zzvladyzz/Karane_Micromouse/IndaV1_Kicad/IndaV1_Kicad.kicad_pcb

## KiCad design IndaV1_Kicad/IndaV1_Kicad.kicad_pcb (2026-05-10)

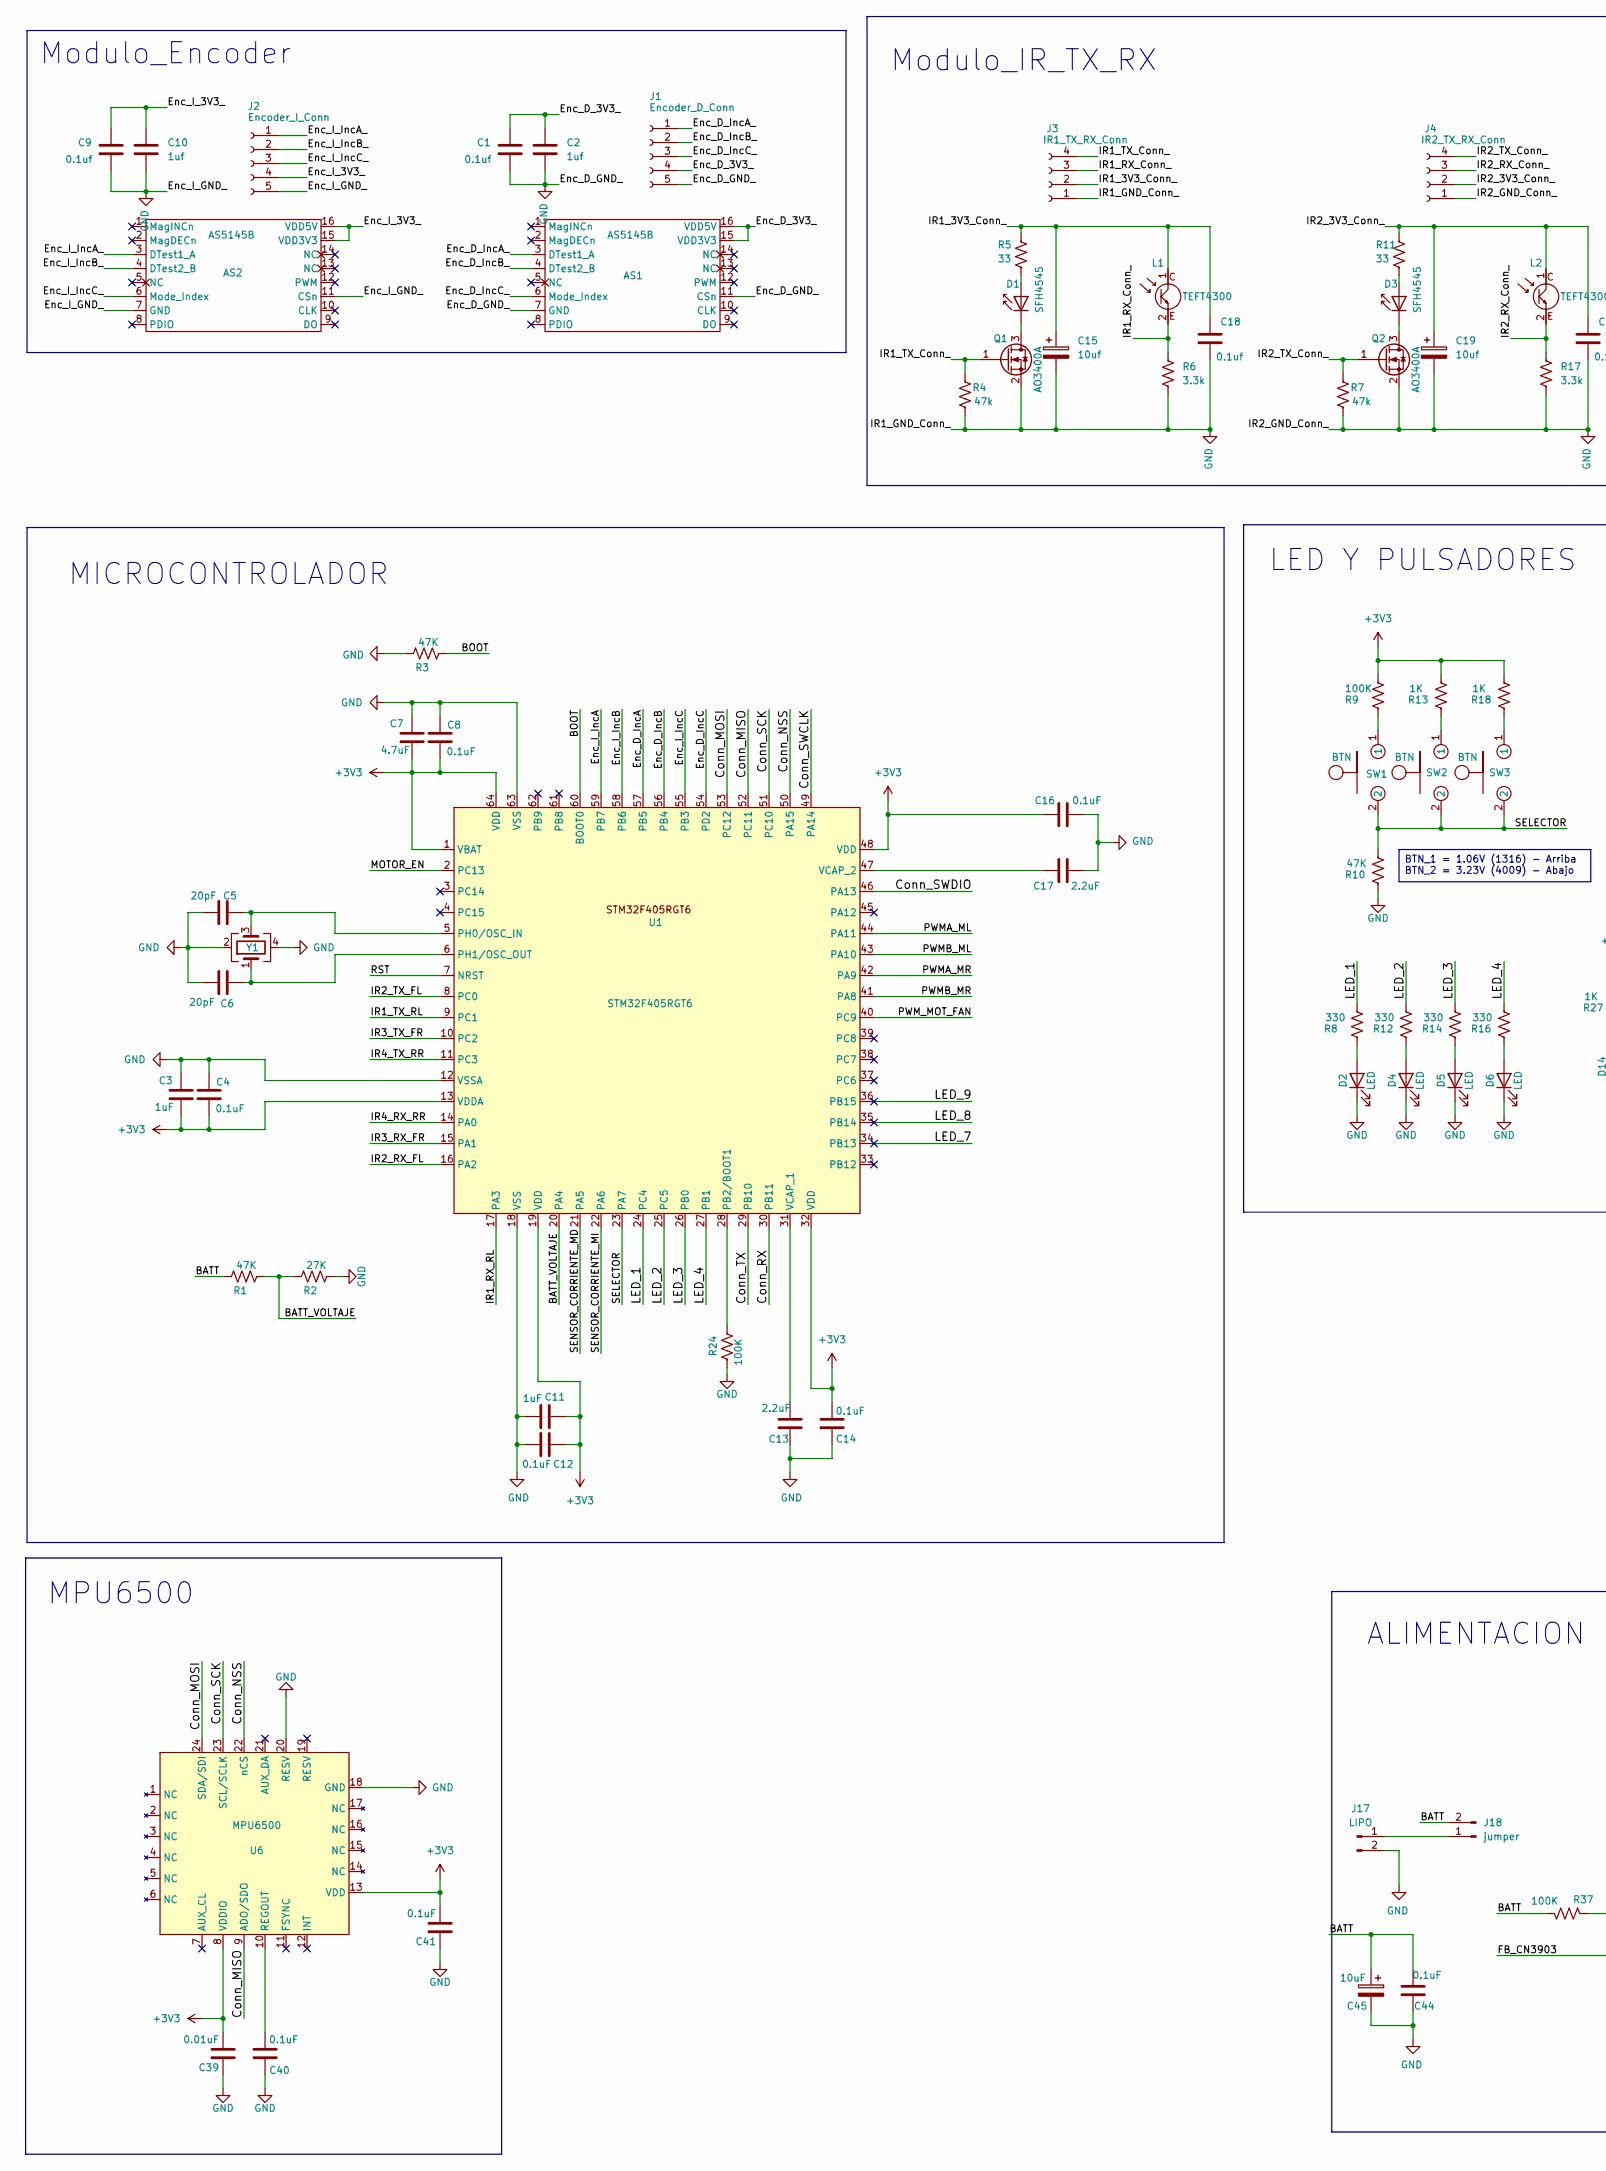
[picture p1: schematic IndaV1_Kicad.kicad_sch, MicroDany, part in row 1, column 1]

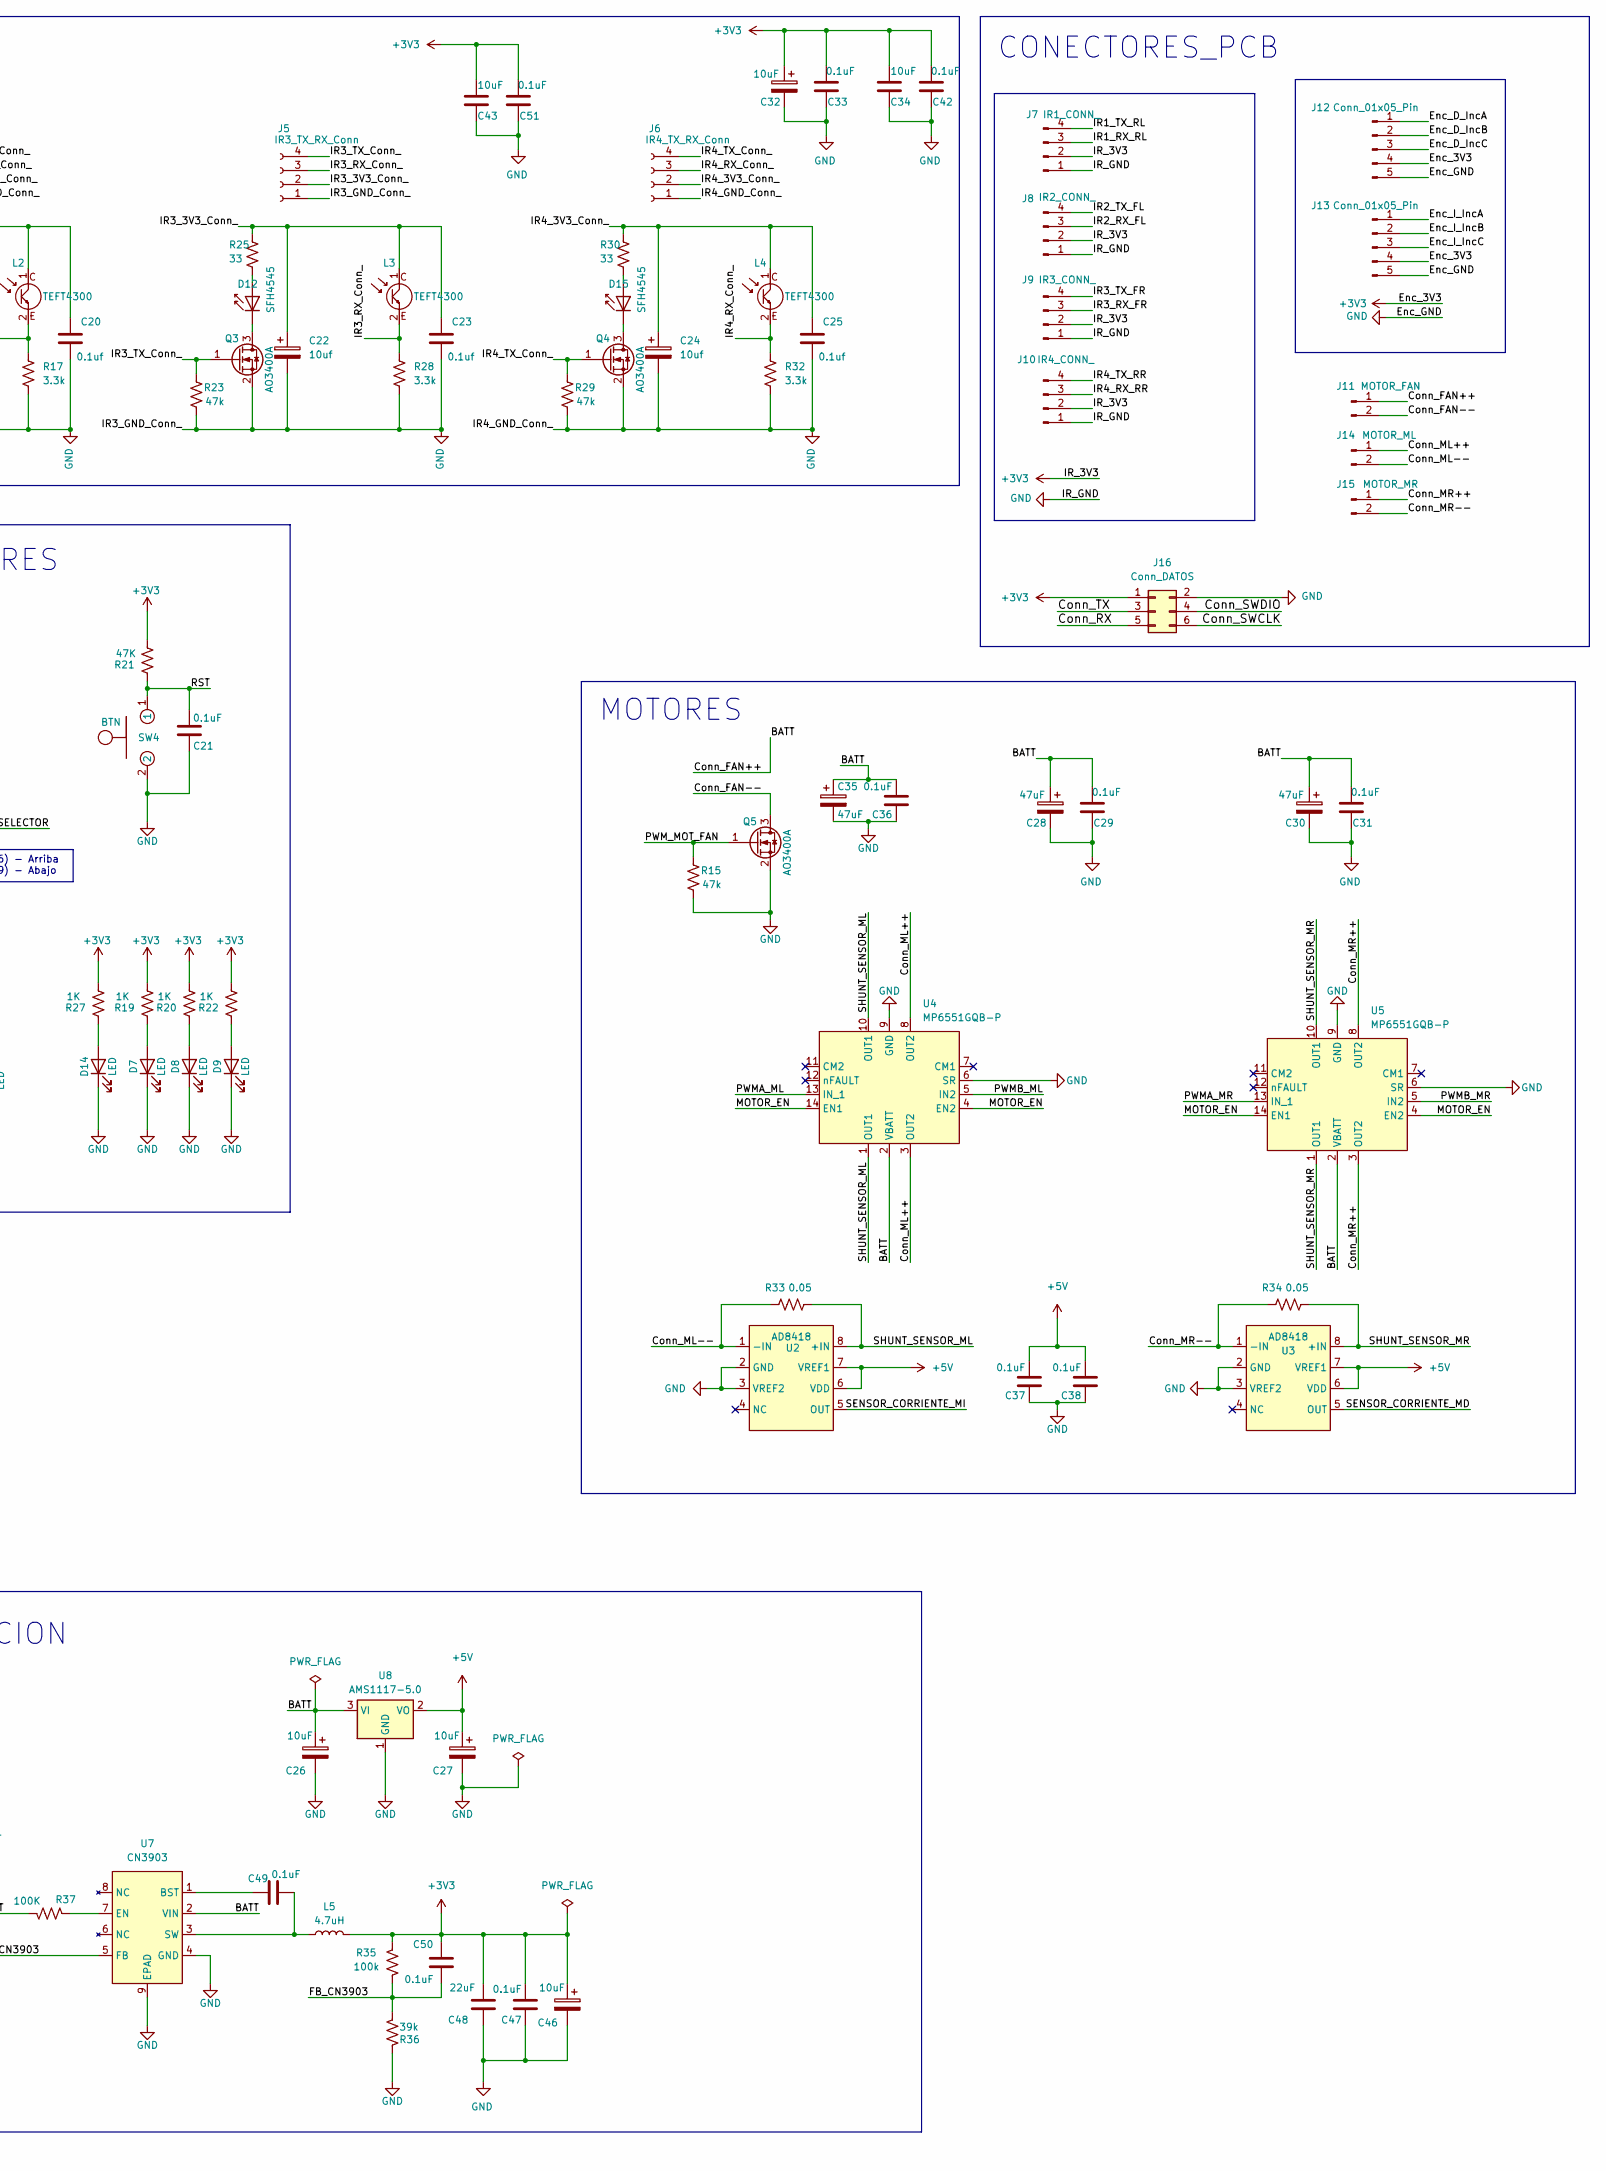
[picture p2: schematic IndaV1_Kicad.kicad_sch, MicroDany, part in row 1, column 2]

Parts:
AS1, AS2: AS5145B; SSOP-16_5.3x6.2mm_P0.65mm
C1, C9, C18, C20, C23, C25: 0.1uf; C_0603_1608Metric_Pad1.08x0.95mm_HandSolder
C2, C10: 1uf; C_1206_3216Metric_Pad1.33x1.80mm_HandSolder
C3, C11: 1uF; C_0603_1608Metric_Pad1.08x0.95mm_HandSolder
C4, C8, C12, C14, C16, C21, C29, C31, C36, C37, C38, C40, C41, C47, C49, C50: 0.1uF; C_0603_1608Metric_Pad1.08x0.95mm_HandSolder
C5, C6: 20pF; C_0603_1608Metric_Pad1.08x0.95mm_HandSolder
C7: 4.7uF; C_0603_1608Metric_Pad1.08x0.95mm_HandSolder
C13, C17: 2.2uF; C_0603_1608Metric_Pad1.08x0.95mm_HandSolder
C15, C19, C22, C24: 10uf; C_0603_1608Metric_Pad1.08x0.95mm_HandSolder
C26, C27, C34, C43: 10uF; C_1206_3216Metric_Pad1.33x1.80mm_HandSolder
C28, C30, C35: 47uF; CP_EIA-7343-15_Kemet-W_HandSolder
C32, C45: 10uF; CP_EIA-7343-15_Kemet-W_HandSolder
C33, C42, C44, C51: 0.1uF; C_1206_3216Metric_Pad1.33x1.80mm_HandSolder
C39: 0.01uF; C_0603_1608Metric_Pad1.08x0.95mm_HandSolder
C46: 10uF; CP_EIA-6032-15_Kemet-U_HandSolder
C48: 22uF; C_0603_1608Metric_Pad1.08x0.95mm_HandSolder
D1, D3, D12, D15: SFH4545; SFH4545_LED
D2, D4, D5, D6, D7, D8, D9, D14: LED; LED_1206_3216Metric_Pad1.42x1.75mm_HandSolder
J1: Encoder_D_Conn; AS5145_Mod
J2: Encoder_I_Conn; AS5145_Mod
J3: IR1_TX_RX_Conn; SFH_TEFT_Mod
J4: IR2_TX_RX_Conn; SFH_TEFT_Mod
J5: IR3_TX_RX_Conn; SFH_TEFT_Mod
J6: IR4_TX_RX_Conn; SFH_TEFT_Mod
J7: IR1_CONN_; SFH_TEFT_CONN_PCB
J8: IR2_CONN_; SFH_TEFT_CONN_PCB
J9: IR3_CONN_; SFH_TEFT_CONN_PCB
J10: IR4_CONN_; SFH_TEFT_CONN_PCB
J11: MOTOR_FAN; PinHeader_1x02_P2.54mm_Vertical
J12, J13: Conn_01x05_Pin; AS5145_CONN_PCB
J14: MOTOR_ML; PinHeader_1x02_P2.54mm_Vertical
J15: MOTOR_MR; PinHeader_1x02_P2.54mm_Vertical
J16: Conn_DATOS; PinHeader_2x03_P2.54mm_Vertical
J17: LIPO; PinHeader_1x02_P2.54mm_Vertical
J18: jumper; PinHeader_1x02_P2.54mm_Vertical
L1, L2, L3, L4: TEFT4300; TEFT4300_LED
L5: 4.7uH; L_Wuerth_HCM-7050
Q1, Q2, Q3, Q4, Q5: AO3400A; SOT-23
R1, R3, R10, R21: 47K; R_0805_2012Metric_Pad1.20x1.40mm_HandSolder
R2: 27K; R_0805_2012Metric_Pad1.20x1.40mm_HandSolder
R4, R7, R15, R23, R29: 47k; R_0805_2012Metric_Pad1.20x1.40mm_HandSolder
R5, R11, R25, R30: 33; R_0805_2012Metric_Pad1.20x1.40mm_HandSolder
R6, R17, R28, R32: 3.3k; R_0805_2012Metric_Pad1.20x1.40mm_HandSolder
R8, R12, R14, R16: 330; R_0805_2012Metric_Pad1.20x1.40mm_HandSolder
R9, R24, R37: 100K; R_0805_2012Metric_Pad1.20x1.40mm_HandSolder
R13, R18, R19, R20, R22, R27: 1K; R_0805_2012Metric_Pad1.20x1.40mm_HandSolder
R33, R34: 0.05; R_2512_6332Metric_Pad1.40x3.35mm_HandSolder
R35: 100k; R_0805_2012Metric_Pad1.20x1.40mm_HandSolder
R36: 39k; R_0805_2012Metric_Pad1.20x1.40mm_HandSolder
SW1, SW2, SW3, SW4: BTN; SW_Push_SPST_NO_Alps_SKRK
U1: STM32F405RGT6; LQFP-64_10x10mm_P0.5mm
U2, U3: AD8418
U4, U5: MP6551GQB-P; MP6551
U6: MPU6500; InvenSense_QFN-24_3x3mm_P0.4mm
U7: CN3903; SOP-8-1EP_4.57x4.57mm_P1.27mm_EP4.57x4.45mm
U8: AMS1117-5.0; SOT-223-3_TabPin2
Y1: Crystal_GND24; Crystal_SMD_TXC_7M-4Pin_3.2x2.5mm_HandSoldering

Connections:
+3V3: C3.1, C4.2, C7.1, C8.2, C11.2, C12.1, C14.1, C16.1, C32.1, C33.1, C34.1, C39.2, C41.2, C42.1, C43.1, C46.1, C47.1, C48.1, C50.2, C51.1, J7.2, J8.2, J9.2, J10.2, J12.4, J13.4, J16.1, L5.1, R9.1, R13.1, R18.1, R19.1, R20.1, R21.1, R22.1, R27.1, R35.1, U1.1 (VBAT), U1.13 (VDDA), U1.19 (VDD), U1.32 (VDD), U1.48 (VDD), U1.64 (VDD), U6.8 (VDDIO), U6.13 (VDD)
+5V: C27.1, C37.2, C38.2, U2.6 (VDD), U2.7 (VREF1), U3.6 (VDD), U3.7 (VREF1), U8.2 (VO)
/BATT: C26.1, C28.1, C29.1, C30.1, C31.1, C35.1, C36.2, C44.1, C45.1, J11.1, J18.2, R1.2, R37.2, U4.2 (VBATT), U5.2 (VBATT), U7.2 (VIN), U8.3 (VI)
/BATT_VOLTAJE: R1.1, R2.2, U1.20 (PA4)
/BOOT: R3.1, U1.60 (BOOT0)
/Conn_FAN--: J11.2, Q5.3 (D)
/Conn_MISO: U1.52 (PC11), U6.9 (ADO/SDO)
/Conn_ML++: J14.1, U4.3 (OUT2), U4.8 (OUT2)
/Conn_ML--: J14.2, R33.1, U2.1 (-IN)
/Conn_MOSI: U1.53 (PC12), U6.24 (SDA/SDI)
/Conn_MR++: J15.1, U5.3 (OUT2), U5.8 (OUT2)
/Conn_MR--: J15.2, R34.1, U3.1 (-IN)
/Conn_NSS: U1.50 (PA15), U6.22 (nCS)
/Conn_RX: J16.5, U1.30 (PB11)
/Conn_SCK: U1.51 (PC10), U6.23 (SCL/SCLK)
/Conn_SWCLK: J16.6, U1.49 (PA14)
/Conn_SWDIO: J16.4, U1.46 (PA13)
/Conn_TX: J16.3, U1.29 (PB10)
/Enc_D_3V3_: AS1.15 (VDD3V3), AS1.16 (VDD5V), C1.1, C2.1, J1.4
/Enc_D_IncA: J12.1, U1.57 (PB5)
/Enc_D_IncA_: AS1.3 (DTest1_A), J1.1
/Enc_D_IncB: J12.2, U1.56 (PB4)
/Enc_D_IncB_: AS1.4 (DTest2_B), J1.2
/Enc_D_IncC: J12.3, U1.54 (PD2)
/Enc_D_IncC_: AS1.6 (Mode_Index), J1.3
/Enc_I_3V3_: AS2.15 (VDD3V3), AS2.16 (VDD5V), C9.1, C10.1, J2.4
/Enc_I_IncA: J13.1, U1.59 (PB7)
/Enc_I_IncA_: AS2.3 (DTest1_A), J2.1
/Enc_I_IncB: J13.2, U1.58 (PB6)
/Enc_I_IncB_: AS2.4 (DTest2_B), J2.2
/Enc_I_IncC: J13.3, U1.55 (PB3)
/Enc_I_IncC_: AS2.6 (Mode_Index), J2.3
/FB_CN3903: C50.1, R35.2, R36.1, U7.5 (FB)
/IR1_3V3_Conn_: C15.1, C18.1, J3.2, L1.1 (C), R5.1
/IR1_RX_Conn_: J3.3, L1.2 (E), R6.1
/IR1_RX_RL: J7.3, U1.17 (PA3)
/IR1_TX_Conn_: J3.4, Q1.1 (G), R4.1
/IR1_TX_RL: J7.4, U1.9 (PC1)
/IR2_3V3_Conn_: C19.1, C20.1, J4.2, L2.1 (C), R11.1
/IR2_RX_Conn_: J4.3, L2.2 (E), R17.1
/IR2_RX_FL: J8.3, U1.16 (PA2)
/IR2_TX_Conn_: J4.4, Q2.1 (G), R7.1
/IR2_TX_FL: J8.4, U1.8 (PC0)
/IR3_3V3_Conn_: C22.1, C23.1, J5.2, L3.1 (C), R25.1
/IR3_RX_Conn_: J5.3, L3.2 (E), R28.1
/IR3_RX_FR: J9.3, U1.15 (PA1)
/IR3_TX_Conn_: J5.4, Q3.1 (G), R23.1
/IR3_TX_FR: J9.4, U1.10 (PC2)
/IR4_3V3_Conn_: C24.1, C25.1, J6.2, L4.1 (C), R30.1
/IR4_RX_Conn_: J6.3, L4.2 (E), R32.1
/IR4_RX_RR: J10.3, U1.14 (PA0)
/IR4_TX_Conn_: J6.4, Q4.1 (G), R29.1
/IR4_TX_RR: J10.4, U1.11 (PC3)
/LED_1: R8.1, U1.24 (PC4)
/LED_2: R12.1, U1.25 (PC5)
/LED_3: R14.1, U1.26 (PB0)
/LED_4: R16.1, U1.27 (PB1)
/LED_7: U1.34 (PB13)
/LED_8: U1.35 (PB14)
/LED_9: U1.36 (PB15)
/MOTOR_EN: U1.2 (PC13), U4.4 (EN2), U4.14 (EN1), U5.4 (EN2), U5.14 (EN1)
/PWMA_ML: U1.44 (PA11), U4.13 (IN_1)
/PWMA_MR: U1.42 (PA9), U5.13 (IN_1)
/PWMB_ML: U1.43 (PA10), U4.5 (IN2)
/PWMB_MR: U1.41 (PA8), U5.5 (IN2)
/PWM_MOT_FAN: Q5.1 (G), R15.1, U1.40 (PC9)
/RST: C21.1, R21.2, SW4.1, U1.7 (NRST)
/SELECTOR: R10.1, SW1.2, SW2.2, SW3.2, U1.23 (PA7)
/SENSOR_CORRIENTE_MD: U1.21 (PA5), U3.5 (OUT)
/SENSOR_CORRIENTE_MI: U1.22 (PA6), U2.5 (OUT)
/SHUNT_SENSOR_ML: R33.2, U2.8 (+IN), U4.1 (OUT1), U4.10 (OUT1)
/SHUNT_SENSOR_MR: R34.2, U3.8 (+IN), U5.1 (OUT1), U5.10 (OUT1)
GND: AS1.7 (GND), AS1.11 (CSn), AS2.7 (GND), AS2.11 (CSn), C1.2, C2.2, C3.2, C4.1, C5.1, C6.1, C7.2, C8.1, C9.2, C10.2, C11.1, C12.2, C13.2, C14.2, C15.2, C16.2, C17.1, C18.2, C19.2, C20.2, C21.2, C22.2, C23.2, C24.2, C25.2, C26.2, C27.2, C28.2, C29.2, C30.2, C31.2, C32.2, C33.2, C34.2, C35.2, C36.1, C37.1, C38.1, C39.1, C40.1, C41.1, C42.2, C43.2, C44.2, C45.2, C46.2, C47.2, C48.2, C51.2, D2.1 (K), D4.1 (K), D5.1 (K), D6.1 (K), D7.1 (K), D8.1 (K), D9.1 (K), D14.1 (K), J1.5, J2.5, J3.1, J4.1, J5.1, J6.1, J7.1, J8.1, J9.1, J10.1, J12.5, J13.5, J16.2, J17.2, Q1.2 (S), Q2.2 (S), Q3.2 (S), Q4.2 (S), Q5.2 (S), R2.1, R3.2, R4.2, R6.2, R7.2, R10.2, R15.2, R17.2, R23.2, R24.1, R28.2, R29.2, R32.2, R36.2, SW4.2, U1.12 (VSSA), U1.18 (VSS), U1.63 (VSS), U2.2 (GND), U2.3 (VREF2), U3.2 (GND), U3.3 (VREF2), U4.6 (SR), U4.9 (GND), U5.6 (SR), U5.9 (GND), U6.18 (GND), U6.20 (RESV), U7.4 (GND), U7.9 (EPAD), U8.1 (GND), Y1.2, Y1.4
unnamed: D1.2 (A), R5.2
unnamed: D1.1 (K), Q1.3 (D)
unnamed: D2.2 (A), R8.2
unnamed: D3.2 (A), R11.2
unnamed: D3.1 (K), Q2.3 (D)
unnamed: D4.2 (A), R12.2
unnamed: D5.2 (A), R14.2
unnamed: D6.2 (A), R16.2
unnamed: D7.2 (A), R19.2
unnamed: D8.2 (A), R20.2
unnamed: D9.2 (A), R22.2
unnamed: D12.2 (A), R25.2
unnamed: D12.1 (K), Q3.3 (D)
unnamed: D14.2 (A), R27.2
unnamed: D15.2 (A), R30.2
unnamed: D15.1 (K), Q4.3 (D)
unnamed: J17.1, J18.1
unnamed: R9.2, SW1.1
unnamed: R13.2, SW2.1
unnamed: R18.2, SW3.1
unnamed: R24.2, U1.28 (PB2/BOOT1)
unnamed: C5.2, U1.5 (PH0/OSC_IN), Y1.3
unnamed: C6.2, U1.6 (PH1/OSC_OUT), Y1.1
unnamed: C13.1, U1.31 (VCAP_1)
unnamed: C17.2, U1.47 (VCAP_2)
unnamed: C40.2, U6.10 (REGOUT)
unnamed: C49.2, U7.1 (BST)
unnamed: R37.1, U7.7 (EN)
unnamed: C49.1, L5.2, U7.3 (SW)

Notes on the sheet:
CONECTORES_PCB
MPU6500
MOTORES
Modulo_IR_TX_RX
ALIMENTACION
LED Y PULSADORES
Modulo_Encoder
MICROCONTROLADOR
BTN_1 = 1.06V (1316) - Arriba BTN_2 = 3.23V (4009) - Abajo

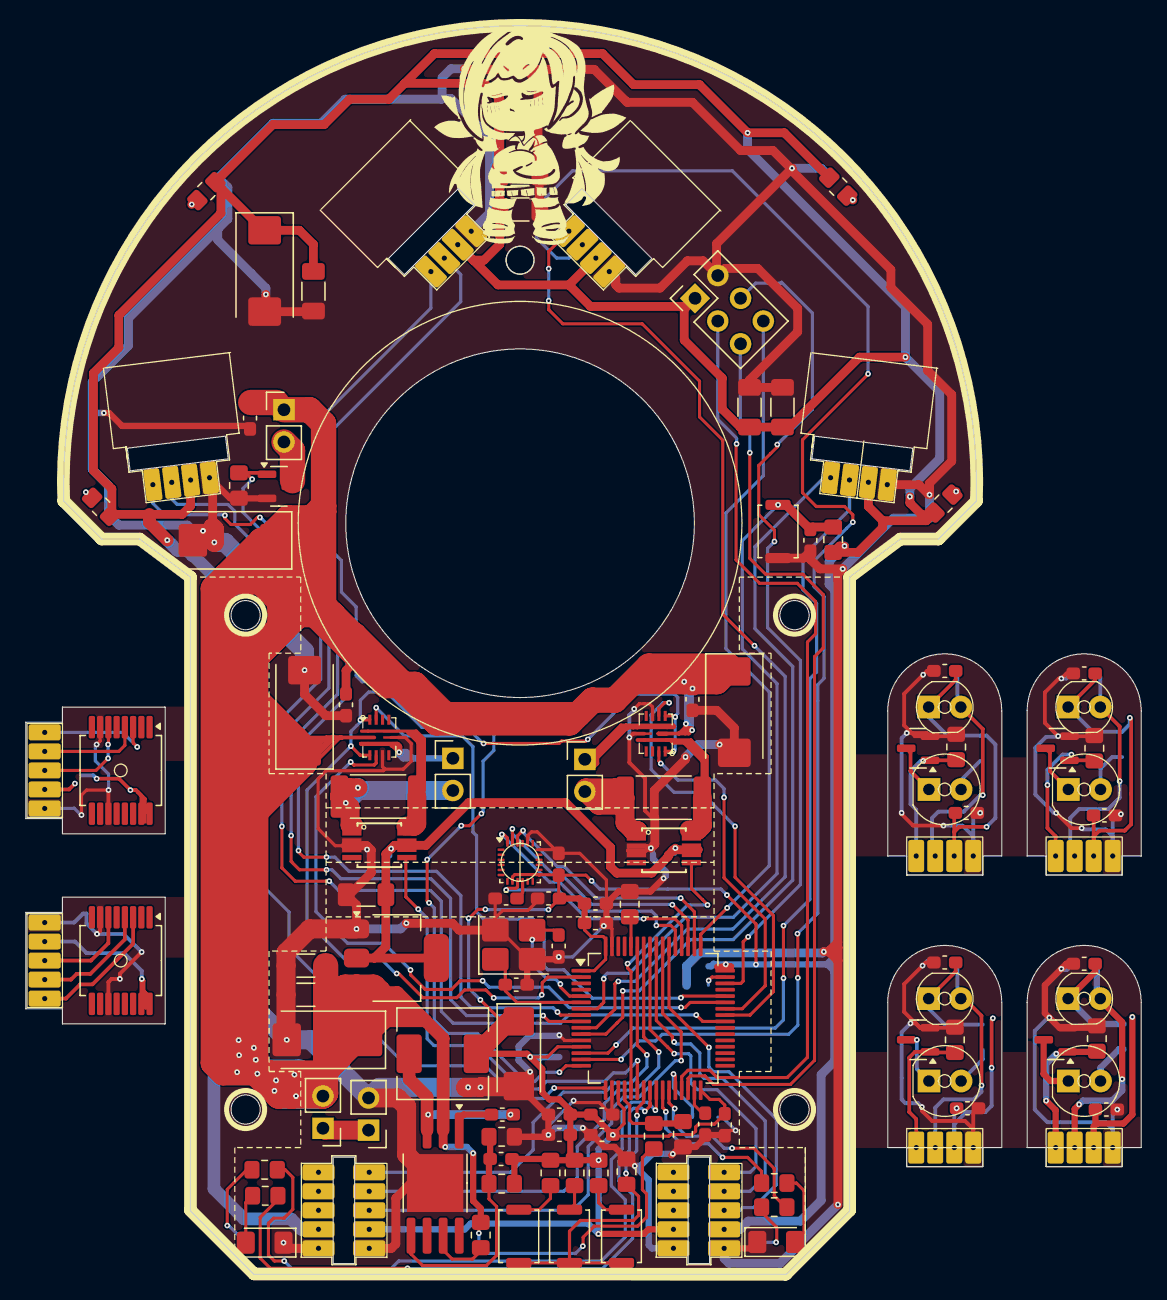
[picture p3: board IndaV1_Kicad.kicad_pcb from above]

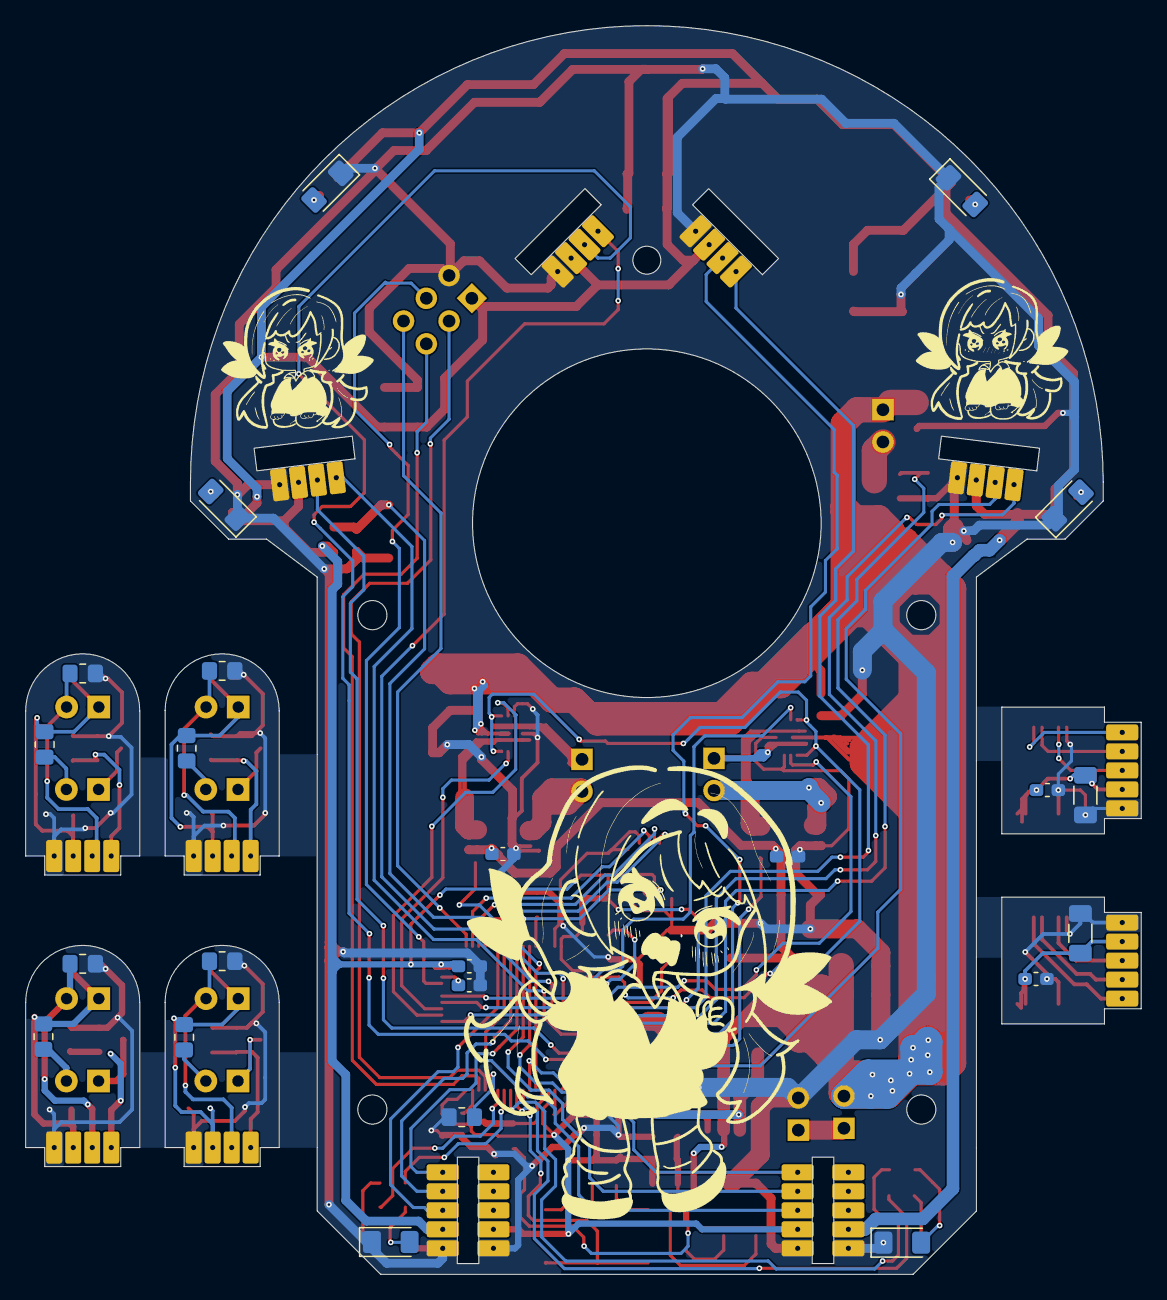
[picture p4: board IndaV1_Kicad.kicad_pcb from below]

Board: 2 copper layers, 72.0 x 98.5 mm, 145 parts (28 on the bottom side), 99 nets.

Other parts of the board:
., .#2, .#3, .#4: LOGO
