zzvladyzz/Karane_Micromouse/Hakari_Kicad/Hakari_Kicad.kicad_pcb

## KiCad design Hakari_Kicad/Hakari_Kicad.kicad_pcb (2026-04-26)

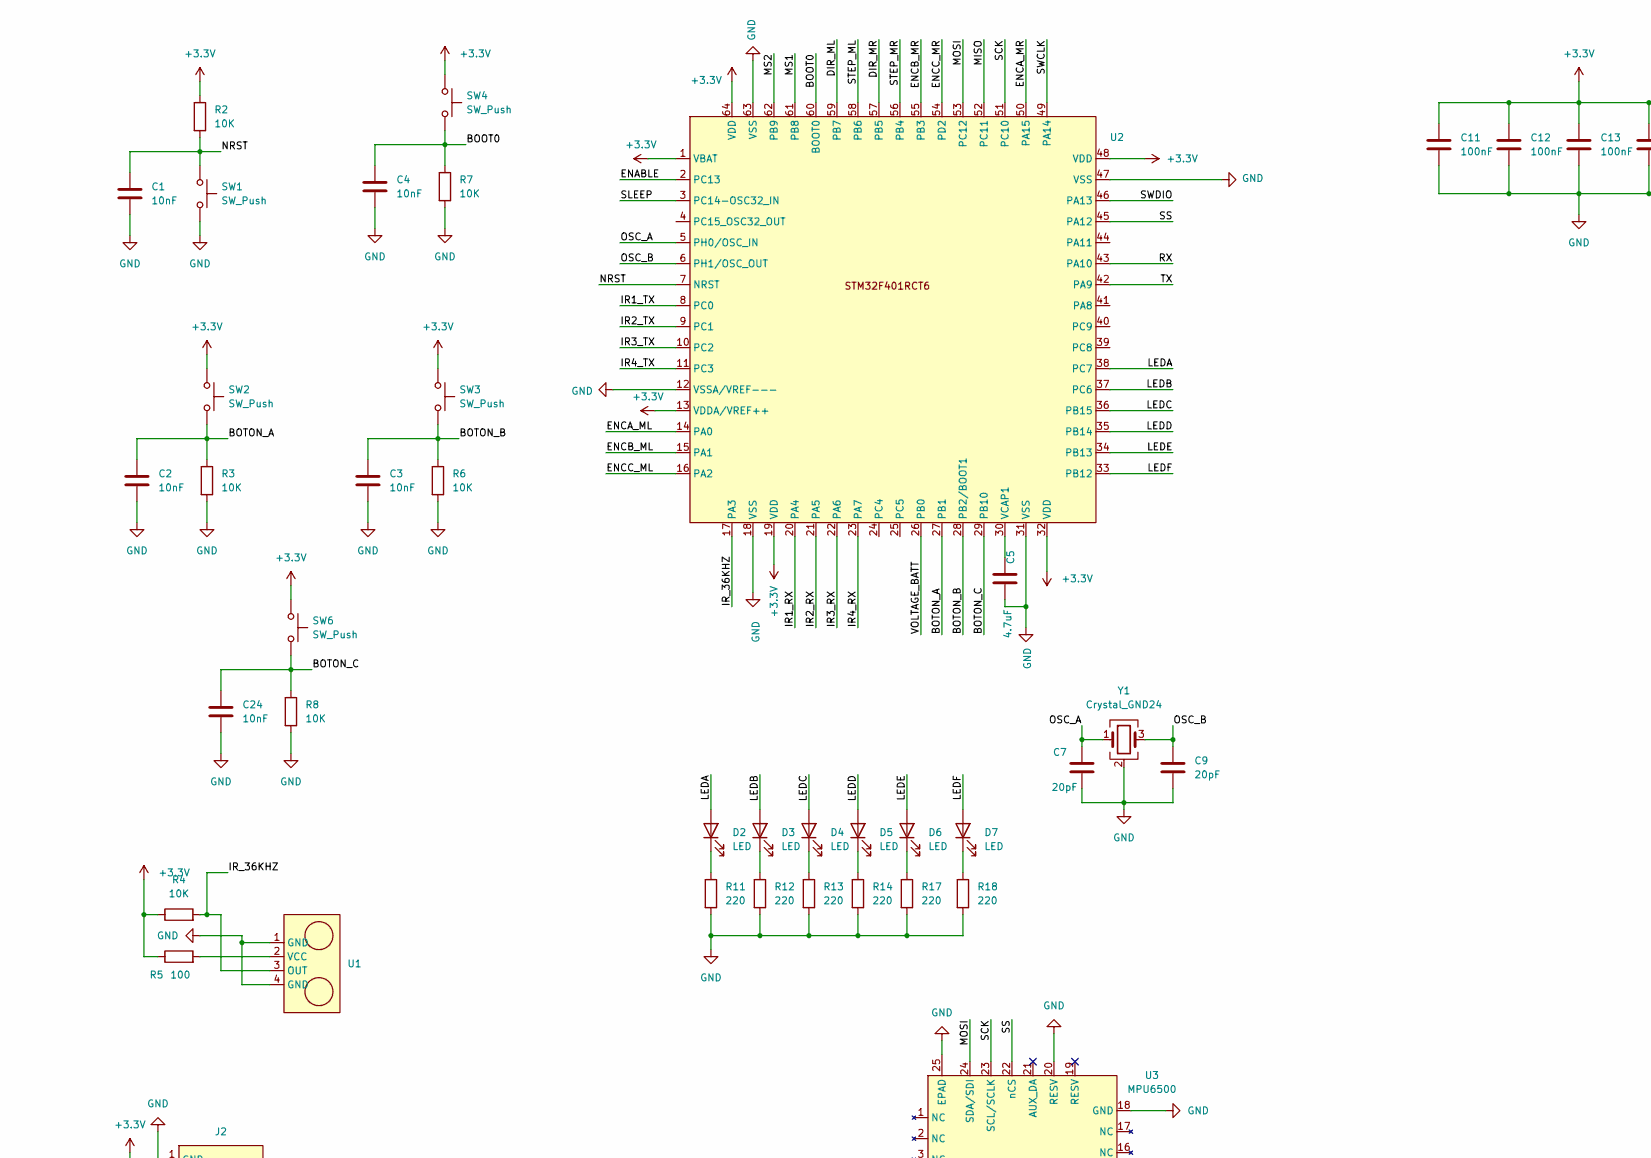
[picture p5: schematic Hakari_Kicad.kicad_sch, part in row 1, column 1]

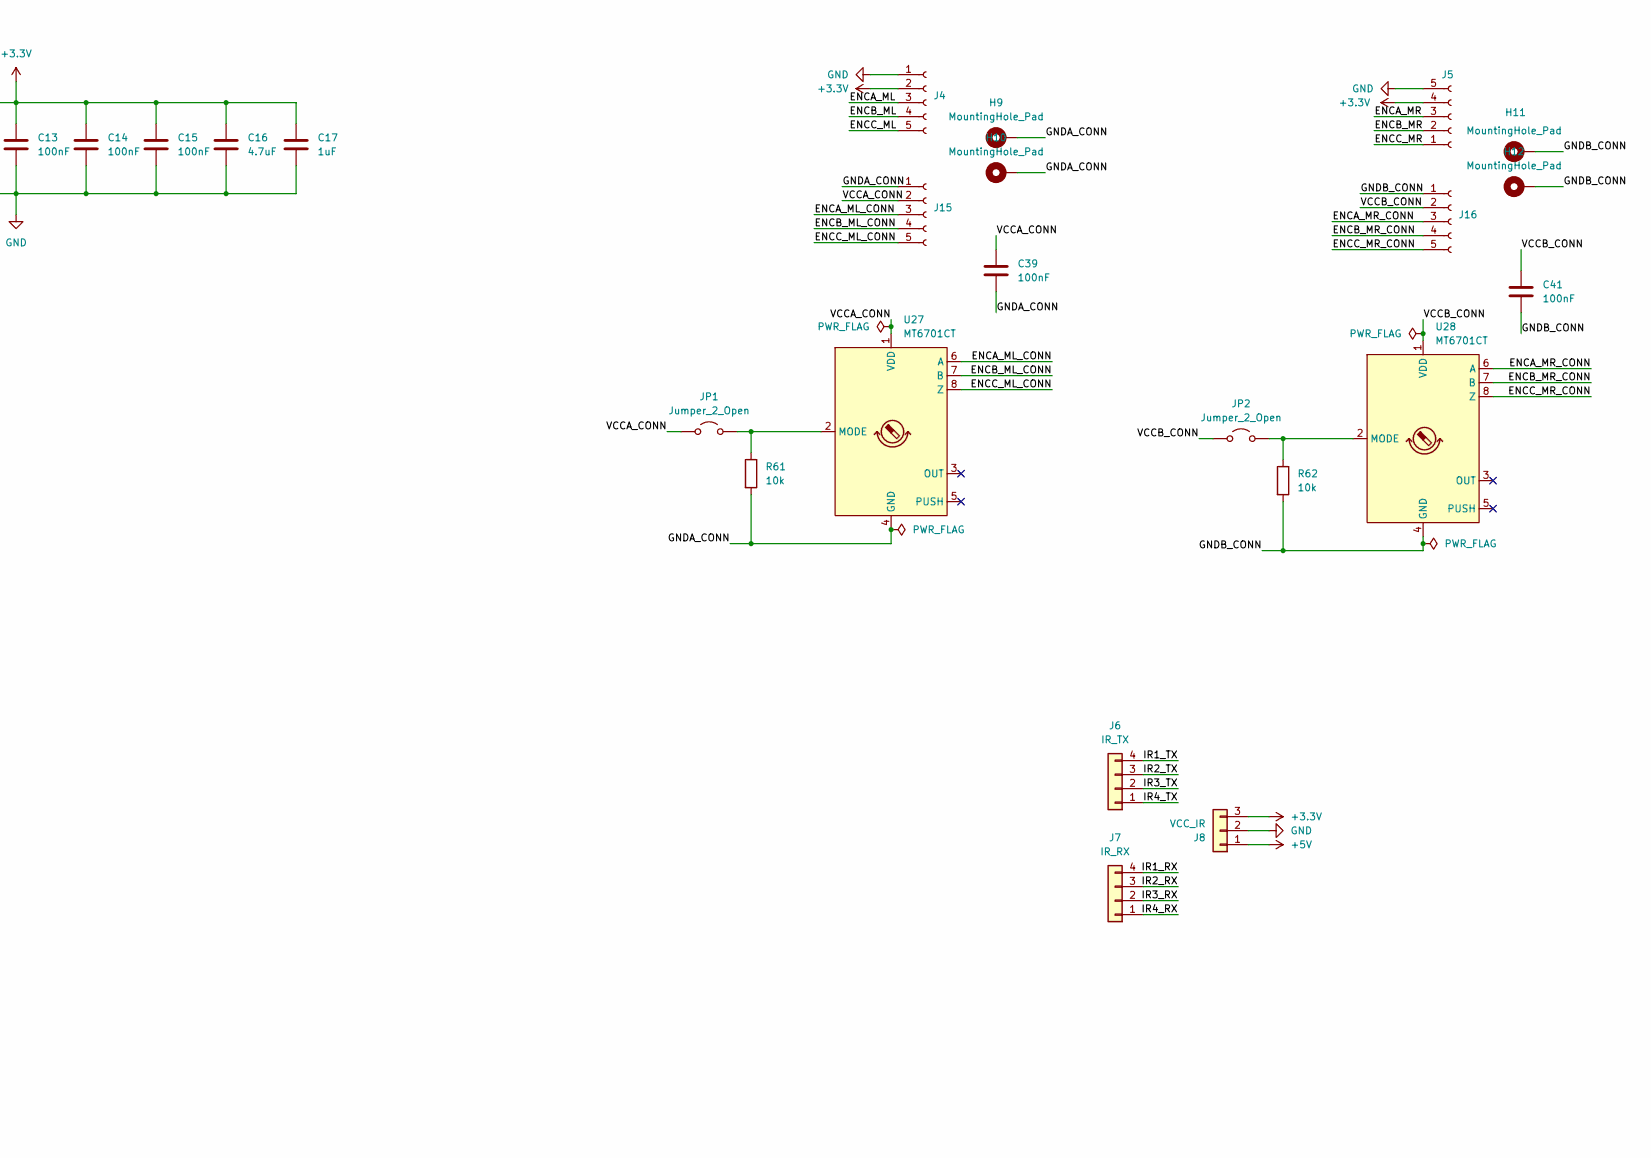
[picture p6: schematic Hakari_Kicad.kicad_sch, part in row 1, column 2]

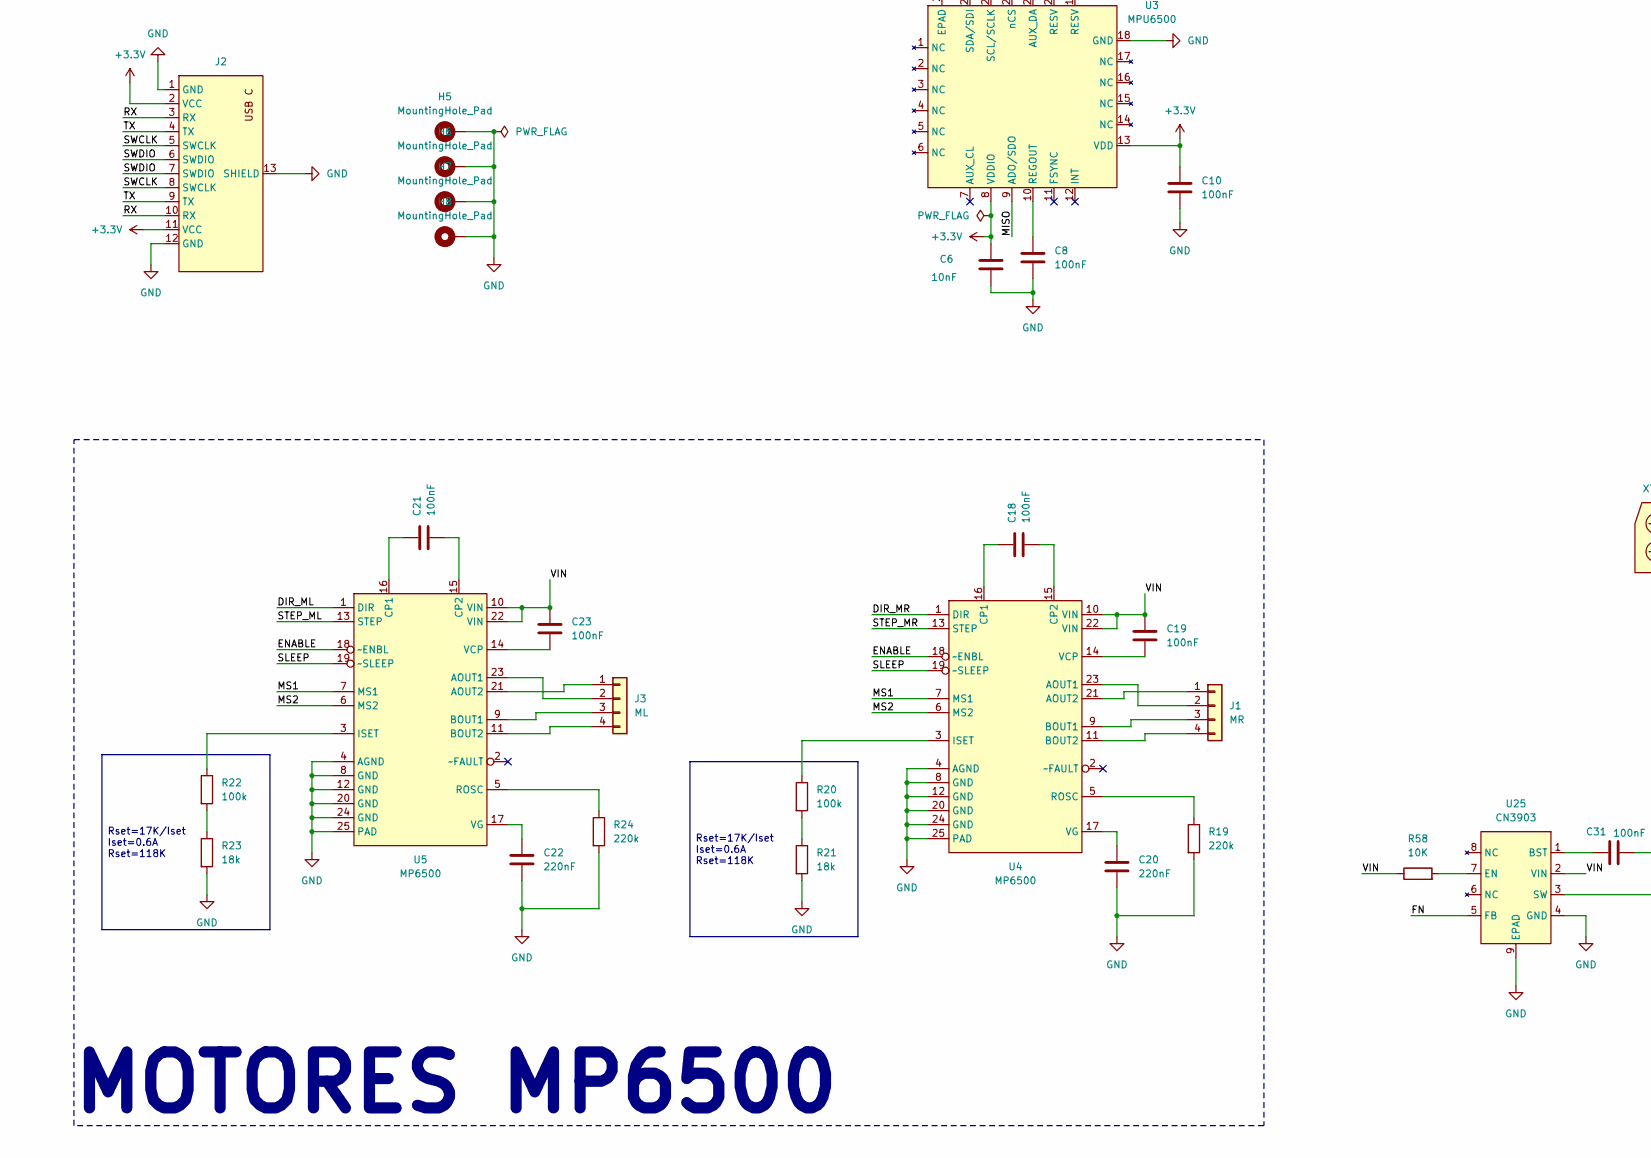
[picture p7: schematic Hakari_Kicad.kicad_sch, part in row 2, column 1]

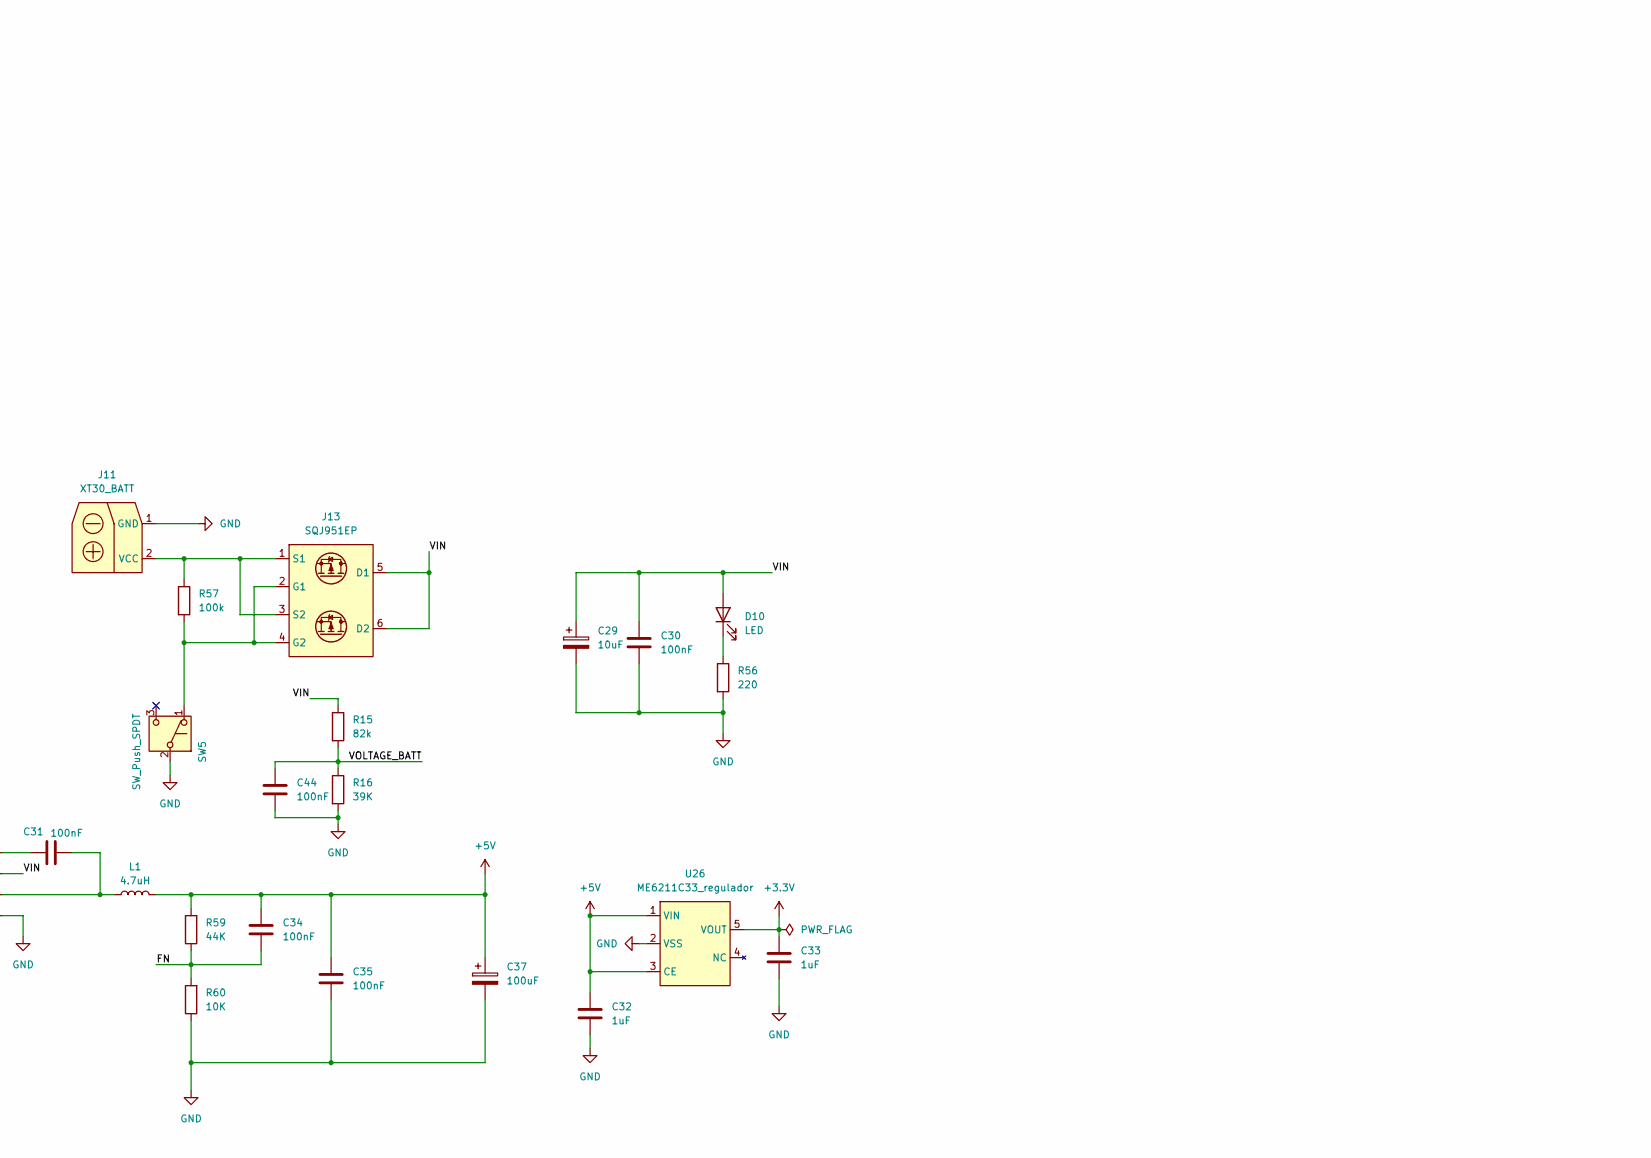
[picture p8: schematic Hakari_Kicad.kicad_sch, part in row 2, column 2]

Parts:
C1, C2, C3, C4, C6, C24: 10nF; C_0603_1608Metric_Pad1.08x0.95mm_HandSolder
C5, C16: 4.7uF; C_0603_1608Metric_Pad1.08x0.95mm_HandSolder
C7, C9: 20pF; C_0603_1608Metric_Pad1.08x0.95mm_HandSolder
C8, C10, C11, C12, C13, C14, C15, C30, C31, C34, C35, C39, C41, C44: 100nF; C_0603_1608Metric_Pad1.08x0.95mm_HandSolder
C17, C32, C33: 1uF; C_0603_1608Metric_Pad1.08x0.95mm_HandSolder
C18, C19, C21, C23: 100nF; C_0805_2012Metric_Pad1.18x1.45mm_HandSolder
C20, C22: 220nF; C_0805_2012Metric_Pad1.18x1.45mm_HandSolder
C29: 10uF; CP_EIA-6032-15_Kemet-U_HandSolder
C37: 100uF; CP_EIA-6032-15_Kemet-U_HandSolder
D2, D3, D4, D5, D6, D7, D10: LED; LED_1206_3216Metric_Pad1.42x1.75mm_HandSolder
H5, H6, H7, H8, H9, H10, H11, H12: MountingHole_Pad; MountingHole_2.2mm_M2_ISO14580_Pad
J1: MR; Molex_KK-254_AE-6410-04A_1x04_P2.54mm_Vertical
J2: usb_C_stm32
J3: ML; Molex_KK-254_AE-6410-04A_1x04_P2.54mm_Vertical
J4, J5: PinHeader_1x05_P2.54mm_Vertical
J6: IR_TX; CONN_SMD_01X04_IR
J7: IR_RX; CONN_SMD_01X04_IR
J8: VCC_IR; CONN_SMD_01X03_IR
J11: XT30_BATT; AMASS_XT30U-F_1x02_P5.0mm_Vertical
J13: SQJ951EP; PowerPAK_SO-8_Dual
J15, J16: AS5145_Mod
JP1, JP2: Jumper_2_Open; SolderJumper-2_P1.3mm_Open_RoundedPad1.0x1.5mm
L1: 4.7uH; L_Wuerth_HCM-7050
R2, R3, R4, R6, R7, R8, R58, R60: 10K; R_0805_2012Metric_Pad1.20x1.40mm_HandSolder
R5: 100; R_0805_2012Metric_Pad1.20x1.40mm_HandSolder
R11, R12, R13, R14, R17, R18, R56: 220; R_0805_2012Metric_Pad1.20x1.40mm_HandSolder
R15: 82k; R_0805_2012Metric_Pad1.20x1.40mm_HandSolder
R16: 39K; R_0805_2012Metric_Pad1.20x1.40mm_HandSolder
R19, R24: 220k; R_0805_2012Metric_Pad1.20x1.40mm_HandSolder
R20, R22, R57: 100k; R_0805_2012Metric_Pad1.20x1.40mm_HandSolder
R21, R23: 18k; R_0805_2012Metric_Pad1.20x1.40mm_HandSolder
R59: 44K; R_0805_2012Metric_Pad1.20x1.40mm_HandSolder
R61, R62: 10k; R_0603_1608Metric_Pad0.98x0.95mm_HandSolder
SW1, SW2, SW3, SW4, SW6: SW_Push; SW_Push_SPST_NO_Alps_SKRK
SW5: SW_Push_SPDT; SW_SPDT_PCM12
U1: IRM-V838
U2: LQFP-64_10x10mm_P0.5mm
U3: MPU6500; QFN-24-1EP_3x3mm_P0.4mm_EP1.75x1.6mm
U4, U5: MP6500
U25: CN3903; HSOP-8-1EP_3.9x4.9mm_P1.27mm_EP2.41x3.1mm
U26: ME6211C33_regulador; SOT-23-5_HandSoldering
U27, U28: MT6701CT; SO-8_3.9x4.9mm_P1.27mm
Y1: Crystal_GND24; Crystal_SMD_3225-4Pin_3.2x2.5mm

Connections:
+3.3V: C6.1, C10.1, C11.1, C12.1, C13.1, C14.1, C15.1, C16.1, C17.1, C33.1, J2.2 (VCC), J2.11 (VCC), J4.2, J5.4, J8.3, R2.1, R4.1, R5.1, SW2.1, SW3.1, SW4.1, SW6.1, U2.1 (VBAT), U2.13 (VDDA/VREF++), U2.19 (VDD), U2.32 (VDD), U2.48 (VDD), U2.64 (VDD), U3.8 (VDDIO), U3.13 (VDD), U26.5 (VOUT)
+5V: C32.1, C34.1, C35.1, C37.1, J8.1, L1.2, R59.2, U26.1 (VIN), U26.3 (CE)
/BOOT0: C4.1, R7.1, SW4.2, U2.60 (BOOT0)
/BOTON_A: C2.1, R3.1, SW2.2, U2.27 (PB1)
/BOTON_B: C3.1, R6.1, SW3.2, U2.28 (PB2/BOOT1)
/BOTON_C: C24.1, R8.1, SW6.2, U2.29 (PB10)
/DIR_ML: U2.59 (PB7), U5.1 (DIR)
/DIR_MR: U2.57 (PB5), U4.1 (DIR)
/ENABLE: U2.2 (PC13), U4.18 (~ENBL), U5.18 (~ENBL)
/ENCA_ML: J4.3, U2.14 (PA0)
/ENCA_ML_CONN: J15.3, U27.6 (A)
/ENCA_MR: J5.3, U2.50 (PA15)
/ENCA_MR_CONN: J16.3, U28.6 (A)
/ENCB_ML: J4.4, U2.15 (PA1)
/ENCB_ML_CONN: J15.4, U27.7 (B)
/ENCB_MR: J5.2, U2.55 (PB3)
/ENCB_MR_CONN: J16.4, U28.7 (B)
/ENCC_ML: J4.5, U2.16 (PA2)
/ENCC_ML_CONN: J15.5, U27.8 (Z)
/ENCC_MR: J5.1, U2.54 (PD2)
/ENCC_MR_CONN: J16.5, U28.8 (Z)
/FN: C34.2, R59.1, R60.2, U25.5 (FB)
/GNDA_CONN: C39.2, H9.1 (1_1), H10.1 (1_1), J15.1, R61.2, U27.4 (GND)
/GNDB_CONN: C41.2, H11.1 (1_1), H12.1 (1_1), J16.1, R62.2, U28.4 (GND)
/IR1_RX: J7.4, U2.20 (PA4)
/IR1_TX: J6.4, U2.8 (PC0)
/IR2_RX: J7.3, U2.21 (PA5)
/IR2_TX: J6.3, U2.9 (PC1)
/IR3_RX: J7.2, U2.22 (PA6)
/IR3_TX: J6.2, U2.10 (PC2)
/IR4_RX: J7.1, U2.23 (PA7)
/IR4_TX: J6.1, U2.11 (PC3)
/IR_36KHZ: R4.2, U1.3 (OUT), U2.17 (PA3)
/LEDA: D2.2 (A), U2.38 (PC7)
/LEDB: D3.2 (A), U2.37 (PC6)
/LEDC: D4.2 (A), U2.36 (PB15)
/LEDD: D5.2 (A), U2.35 (PB14)
/LEDE: D6.2 (A), U2.34 (PB13)
/LEDF: D7.2 (A), U2.33 (PB12)
/MISO: U2.52 (PC11), U3.9 (ADO/SDO)
/MOSI: U2.53 (PC12), U3.24 (SDA/SDI)
/MS1: U2.61 (PB8), U4.7 (MS1), U5.7 (MS1)
/MS2: U2.62 (PB9), U4.6 (MS2), U5.6 (MS2)
/NRST: C1.1, R2.2, SW1.1, U2.7 (NRST)
/OSC_A: C7.1, U2.5 (PH0/OSC_IN), Y1.1
/OSC_B: C9.1, U2.6 (PH1/OSC_OUT), Y1.3
/RX: J2.3 (RX), J2.10 (RX), U2.43 (PA10)
/SCK: U2.51 (PC10), U3.23 (SCL/SCLK)
/SLEEP: U2.3 (PC14-OSC32_IN), U4.19 (~SLEEP), U5.19 (~SLEEP)
/SS: U2.45 (PA12), U3.22 (nCS)
/STEP_ML: U2.58 (PB6), U5.13 (STEP)
/STEP_MR: U2.56 (PB4), U4.13 (STEP)
/SWCLK: J2.5 (SWCLK), J2.8 (SWCLK), U2.49 (PA14)
/SWDIO: J2.6 (SWDIO), J2.7 (SWDIO), U2.46 (PA13)
/TX: J2.4 (TX), J2.9 (TX), U2.42 (PA9)
/VCCA_CONN: C39.1, J15.2, JP1.1 (A), U27.1 (VDD)
/VCCB_CONN: C41.1, J16.2, JP2.1 (A), U28.1 (VDD)
/VIN: C19.1, C23.1, C29.1, C30.1, D10.2 (A), J13.5 (D1), J13.6 (D2), R15.1, R58.1, U4.10 (VIN), U4.22 (VIN), U5.10 (VIN), U5.22 (VIN), U25.2 (VIN)
/VOLTAGE_BATT: C44.1, R15.2, R16.1, U2.26 (PB0)
GND: C1.2, C2.2, C3.2, C4.2, C5.2, C6.2, C7.2, C8.2, C9.2, C10.2, C11.2, C12.2, C13.2, C14.2, C15.2, C16.2, C17.2, C20.2, C22.2, C24.2, C29.2, C30.2, C32.2, C33.2, C35.2, C37.2, C44.2, H5.1 (1_1), H6.1 (1_1), H7.1 (1_1), H8.1 (1_1), J2.1 (GND), J2.12 (GND), J2.13 (SHIELD), J4.1, J5.5, J8.2, J11.1 (GND), R3.2, R6.2, R7.2, R8.2, R11.2, R12.2, R13.2, R14.2, R16.2, R17.2, R18.2, R19.2, R21.2, R23.2, R24.2, R56.2, R60.1, SW1.2, SW5.2 (B), U1.1 (GND), U1.4 (GND), U2.12 (VSSA/VREF---), U2.18 (VSS), U2.31 (VSS), U2.47 (VSS), U2.63 (VSS), U3.18 (GND), U3.20 (RESV), U3.25 (EPAD), U4.4 (AGND), U4.8 (GND), U4.12 (GND), U4.20 (GND), U4.24 (GND), U4.25 (PAD), U5.4 (AGND), U5.8 (GND), U5.12 (GND), U5.20 (GND), U5.24 (GND), U5.25 (PAD), U25.4 (GND), U25.9 (EPAD), U26.2 (VSS), Y1.2 (G), Y1.4 (G)
unnamed: D2.1 (K), R11.1
unnamed: D3.1 (K), R12.1
unnamed: D4.1 (K), R13.1
unnamed: D5.1 (K), R14.1
unnamed: D6.1 (K), R17.1
unnamed: D7.1 (K), R18.1
unnamed: D10.1 (K), R56.1
unnamed: J1.1, U4.21 (AOUT2)
unnamed: J1.2, U4.23 (AOUT1)
unnamed: J1.3, U4.9 (BOUT1)
unnamed: J1.4, U4.11 (BOUT2)
unnamed: J3.1, U5.21 (AOUT2)
unnamed: J3.2, U5.23 (AOUT1)
unnamed: J3.3, U5.9 (BOUT1)
unnamed: J3.4, U5.11 (BOUT2)
unnamed: J11.2 (VCC), J13.1 (S1), J13.3 (S2), R57.1
unnamed: J13.2 (G1), J13.4 (G2), R57.2, SW5.1 (A)
unnamed: JP1.2 (B), R61.1, U27.2 (MODE)
unnamed: JP2.2 (B), R62.1, U28.2 (MODE)
unnamed: R20.2, R21.1
unnamed: R22.2, R23.1
unnamed: R5.2, U1.2 (VCC)
unnamed: C5.1, U2.30 (VCAP1)
unnamed: C8.1, U3.10 (REGOUT)
unnamed: C18.1, U4.16 (CP1)
unnamed: C18.2, U4.15 (CP2)
unnamed: R20.1, U4.3 (ISET)
unnamed: R19.1, U4.5 (ROSC)
unnamed: C19.2, U4.14 (VCP)
unnamed: C20.1, U4.17 (VG)
unnamed: C21.1, U5.16 (CP1)
unnamed: C21.2, U5.15 (CP2)
unnamed: R22.1, U5.3 (ISET)
unnamed: R24.1, U5.5 (ROSC)
unnamed: C23.2, U5.14 (VCP)
unnamed: C22.1, U5.17 (VG)
unnamed: C31.1, U25.1 (BST)
unnamed: R58.2, U25.7 (EN)
unnamed: C31.2, L1.1, U25.3 (SW)

Notes on the sheet:
MOTORES MP6500
Rset=17K/Iset Iset=0.6A Rset=118K

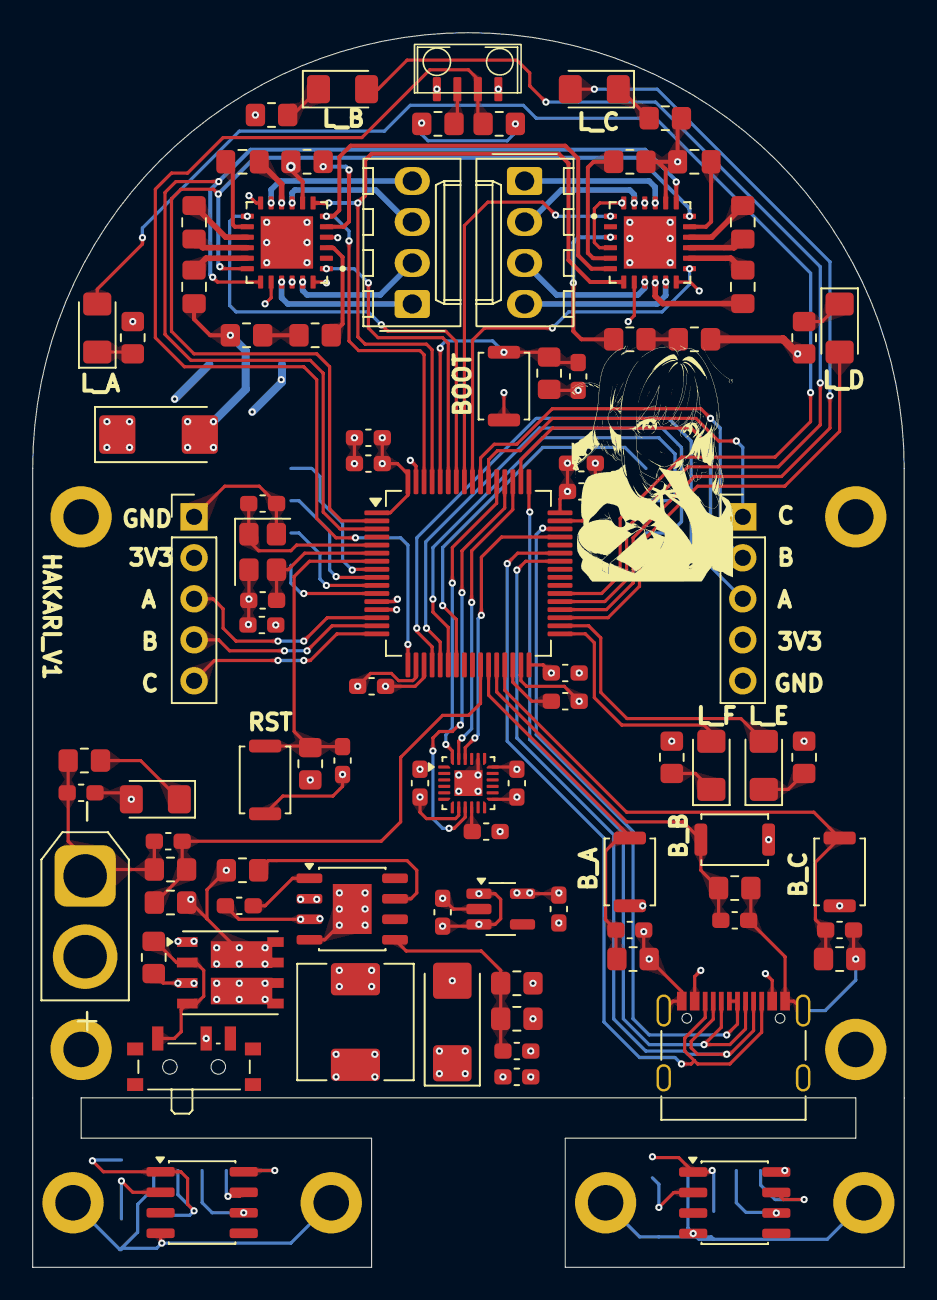
[picture p9: board Hakari_Kicad.kicad_pcb from above]

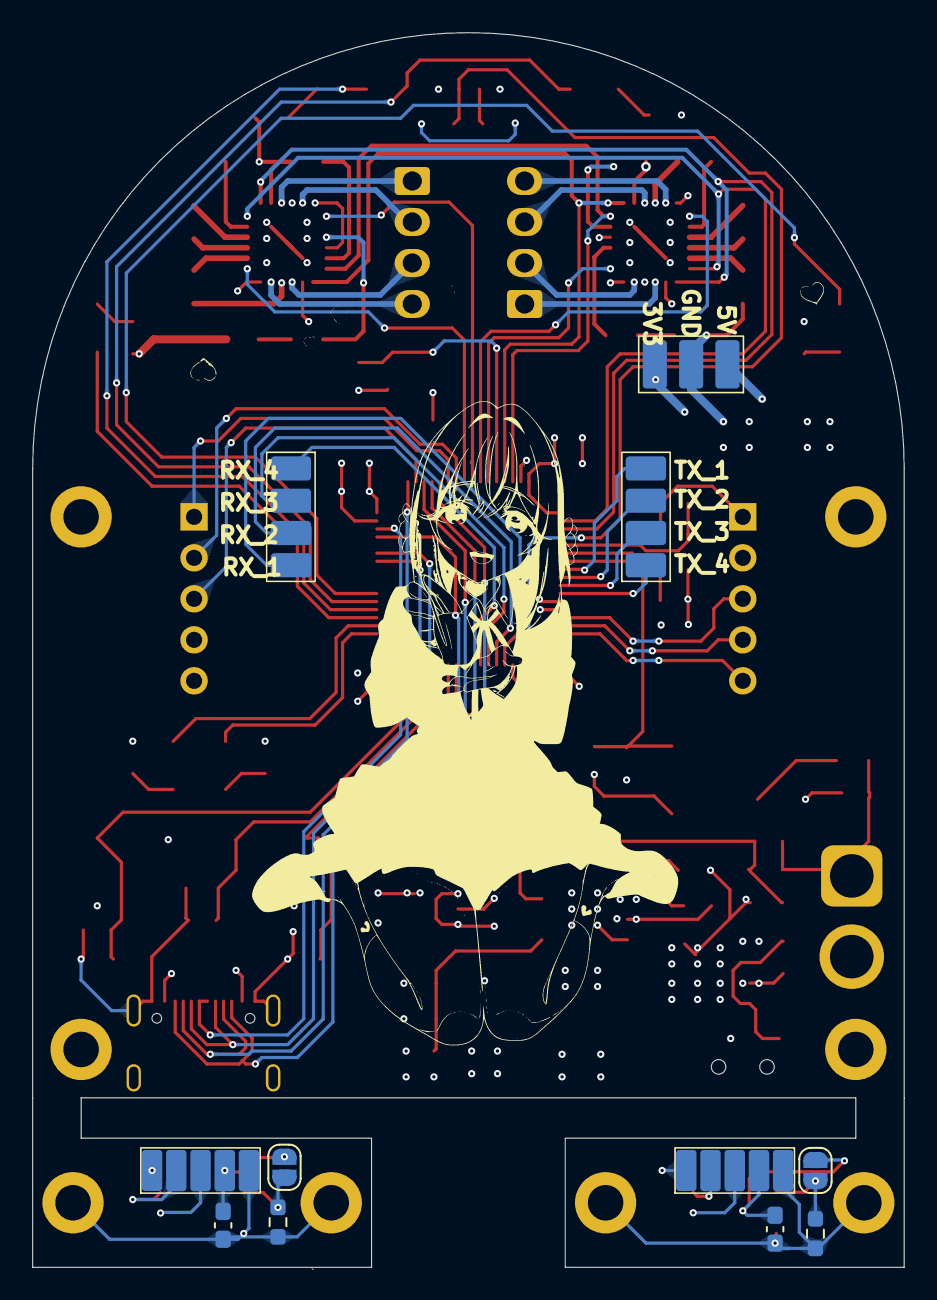
[picture p10: board Hakari_Kicad.kicad_pcb from below]

Board: 4 copper layers, 54.0 x 76.5 mm, 109 parts (11 on the bottom side), 99 nets.
