zzvladyzz/Karane_Micromouse/IndaV1_STM/IndaV1_STM.ioc

Mcu.UserName=STM32F405RGTx
PA0-WKUP.GPIO_Label=IR4_RX
PA0-WKUP.Signal=ADCx_IN0
PA1.GPIO_Label=IR3_RX
PA1.Signal=ADCx_IN1
PA10.GPIO_Label=PWMB_ML
PA10.Signal=S_TIM1_CH3
PA11.GPIO_Label=PWMA_ML
PA11.Signal=S_TIM1_CH4
PA13.Signal=SYS_JTMS-SWDIO
PA14.Signal=SYS_JTCK-SWCLK
PA15.GPIO_Label=SPI_NSS
PA15.Signal=GPIO_Output
PA2.GPIO_Label=IR2_RX
PA2.Signal=ADCx_IN2
PA3.GPIO_Label=IR1_RX
PA3.Signal=ADCx_IN3
PA4.GPIO_Label=VATT
PA4.Signal=ADCx_IN4
PA5.GPIO_Label=A_MD
PA5.Signal=ADCx_IN5
PA6.GPIO_Label=A_MI
PA6.Signal=ADCx_IN6
PA7.GPIO_Label=PULSADOR
PA7.Signal=ADCx_IN7
PA8.GPIO_Label=PWMB_MR
PA8.Signal=S_TIM1_CH1
PA9.GPIO_Label=PWMA_MR
PA9.Signal=S_TIM1_CH2
PB0.GPIO_Label=LED3
PB0.Signal=GPIO_Output
PB1.GPIO_Label=LED4
PB1.Signal=GPIO_Output
PB10.Signal=USART3_TX
PB11.Signal=USART3_RX
PB2.GPIO_Label=BOOT1
PB2.Signal=GPIO_Output
PB3.GPIO_Label=Enc_I_C
PB3.Signal=GPXTI3
PB4.GPIO_Label=Enc_D_B
PB4.Signal=GPXTI4
PB5.GPIO_Label=Enc_D_A
PB5.Signal=GPXTI5
PB6.GPIO_Label=Enc_I_B
PB6.Signal=GPXTI6
PB7.GPIO_Label=Enc_I_A
PB7.Signal=GPXTI7
PC0.GPIO_Label=IR2_TX
PC0.Signal=GPIO_Output
PC1.GPIO_Label=IR1_TX
PC1.Signal=GPIO_Output
PC10.Signal=SPI3_SCK
PC11.Signal=SPI3_MISO
PC12.Signal=SPI3_MOSI
PC13-ANTI_TAMP.GPIO_Label=MOTOR_EN
PC13-ANTI_TAMP.Signal=GPIO_Output
PC2.GPIO_Label=IR3_TX
PC2.Signal=GPIO_Output
PC3.GPIO_Label=IR4_TX
PC3.Signal=GPIO_Output
PC4.GPIO_Label=LED2
PC4.Signal=GPIO_Output
PC5.GPIO_Label=LED1
PC5.Signal=GPIO_Output
PC9.Signal=S_TIM3_CH4
PD2.GPIO_Label=Enc_D_C
PD2.Signal=GPXTI2
PH0-OSC_IN.Signal=RCC_OSC_IN
PH1-OSC_OUT.Signal=RCC_OSC_OUT
