zzvladyzz/Karane_Micromouse/IndaV1_STM/Core/Inc/main.h

#define MOTOR_EN_Pin GPIO_PIN_13
#define MOTOR_EN_GPIO_Port GPIOC
#define IR2_TX_Pin GPIO_PIN_0
#define IR2_TX_GPIO_Port GPIOC
#define IR1_TX_Pin GPIO_PIN_1
#define IR1_TX_GPIO_Port GPIOC
#define IR3_TX_Pin GPIO_PIN_2
#define IR3_TX_GPIO_Port GPIOC
#define IR4_TX_Pin GPIO_PIN_3
#define IR4_TX_GPIO_Port GPIOC
#define IR4_RX_Pin GPIO_PIN_0
#define IR4_RX_GPIO_Port GPIOA
#define IR3_RX_Pin GPIO_PIN_1
#define IR3_RX_GPIO_Port GPIOA
#define IR2_RX_Pin GPIO_PIN_2
#define IR2_RX_GPIO_Port GPIOA
#define IR1_RX_Pin GPIO_PIN_3
#define IR1_RX_GPIO_Port GPIOA
#define VATT_Pin GPIO_PIN_4
#define VATT_GPIO_Port GPIOA
#define A_MD_Pin GPIO_PIN_5
#define A_MD_GPIO_Port GPIOA
#define A_MI_Pin GPIO_PIN_6
#define A_MI_GPIO_Port GPIOA
#define PULSADOR_Pin GPIO_PIN_7
#define PULSADOR_GPIO_Port GPIOA
#define LED2_Pin GPIO_PIN_4
#define LED2_GPIO_Port GPIOC
#define LED1_Pin GPIO_PIN_5
#define LED1_GPIO_Port GPIOC
#define LED3_Pin GPIO_PIN_0
#define LED3_GPIO_Port GPIOB
#define LED4_Pin GPIO_PIN_1
#define LED4_GPIO_Port GPIOB
#define BOOT1_Pin GPIO_PIN_2
#define BOOT1_GPIO_Port GPIOB
#define PWMB_MR_Pin GPIO_PIN_8
#define PWMB_MR_GPIO_Port GPIOA
#define PWMA_MR_Pin GPIO_PIN_9
#define PWMA_MR_GPIO_Port GPIOA
#define PWMB_ML_Pin GPIO_PIN_10
#define PWMB_ML_GPIO_Port GPIOA
#define PWMA_ML_Pin GPIO_PIN_11
#define PWMA_ML_GPIO_Port GPIOA
#define SPI_NSS_Pin GPIO_PIN_15
#define SPI_NSS_GPIO_Port GPIOA
#define Enc_D_C_Pin GPIO_PIN_2
#define Enc_D_C_GPIO_Port GPIOD
#define Enc_D_C_EXTI_IRQn EXTI2_IRQn
#define Enc_I_C_Pin GPIO_PIN_3
#define Enc_I_C_GPIO_Port GPIOB
#define Enc_I_C_EXTI_IRQn EXTI3_IRQn
#define Enc_D_B_Pin GPIO_PIN_4
#define Enc_D_B_GPIO_Port GPIOB
#define Enc_D_B_EXTI_IRQn EXTI4_IRQn
#define Enc_D_A_Pin GPIO_PIN_5
#define Enc_D_A_GPIO_Port GPIOB
#define Enc_D_A_EXTI_IRQn EXTI9_5_IRQn
#define Enc_I_B_Pin GPIO_PIN_6
#define Enc_I_B_GPIO_Port GPIOB
#define Enc_I_B_EXTI_IRQn EXTI9_5_IRQn
#define Enc_I_A_Pin GPIO_PIN_7
#define Enc_I_A_GPIO_Port GPIOB
#define Enc_I_A_EXTI_IRQn EXTI9_5_IRQn
