zzvladyzz/Karane_Micromouse/(commit log)

2026-04-23 kicad agregado
    [Hakari_Kicad.kicad_pcb, Hakari_Kicad.kicad_sch]
2026-04-26 Hakari PCB
    [Hakari_Kicad.kicad_pcb, Hakari_Kicad.kicad_sch]
2026-04-26 Agregada nueva carpeta
    [Hakari_Kicad.kicad_pcb, IndaV1_Kicad.kicad_pcb, IndaV1_Kicad.kicad_sch]
2026-04-27 Se corrigio muestreo y datos de mpu6500
    [IndaV1_STM.ioc, LIB_Motores.c, LIB_Motores.h, main.c, main.h]
2026-04-28 Linealizado sensores con valores obtenidos
    [IndaV1_Kicad.kicad_pcb]
2026-04-28 kicad modificado
    [IndaV1_Kicad.kicad_pcb]
2026-04-30 agregado adc a 16khz
2026-05-02 sensores funcionando a 16khz
2026-05-03 se quito de lib motores un valor de write gpio que no deberia estar
2026-05-04 libr motores corregido
2026-09-06 listo para ser enviado a producir
